radhepa/sic-inverter-800v/figures/03b_loop_inductance.png

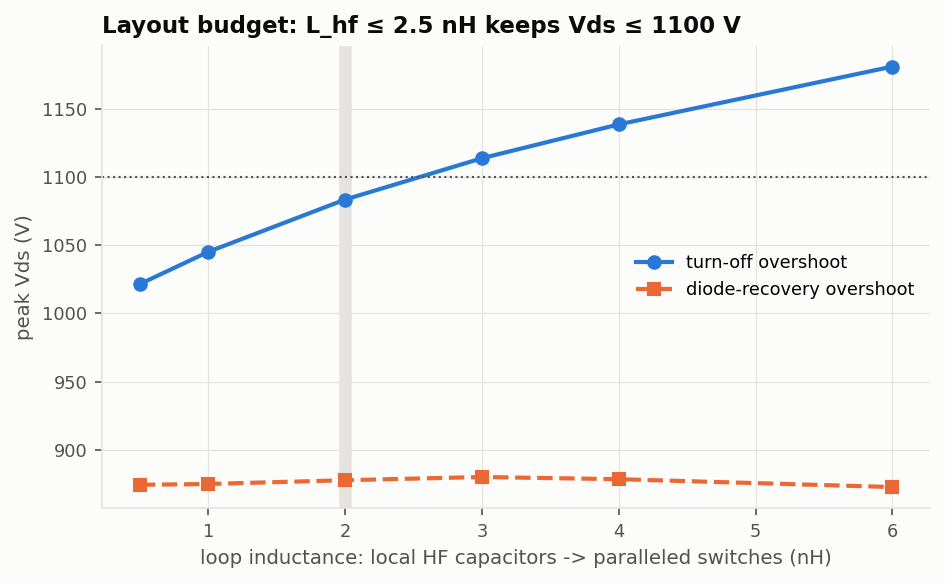
figures/03b_loop_inductance.png
