radhepa/sic-inverter-800v/figures/03c_energy_table.png

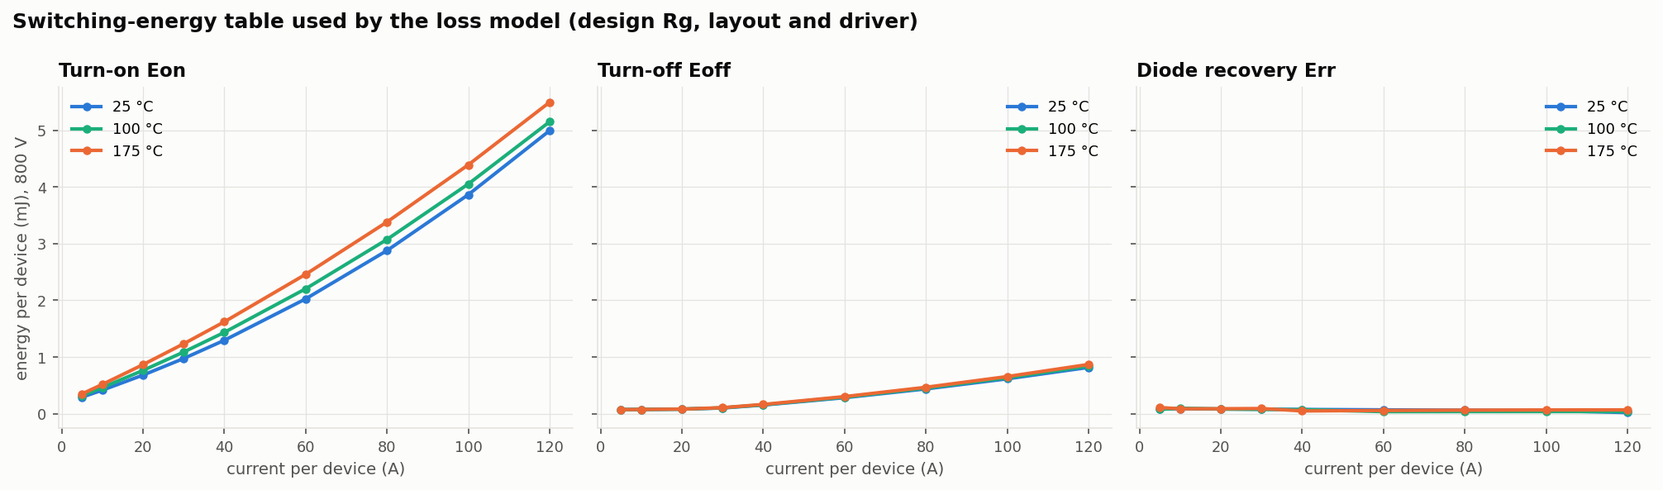
figures/03c_energy_table.png
