radhepa/sic-inverter-800v/figures/03e_paralleling.png

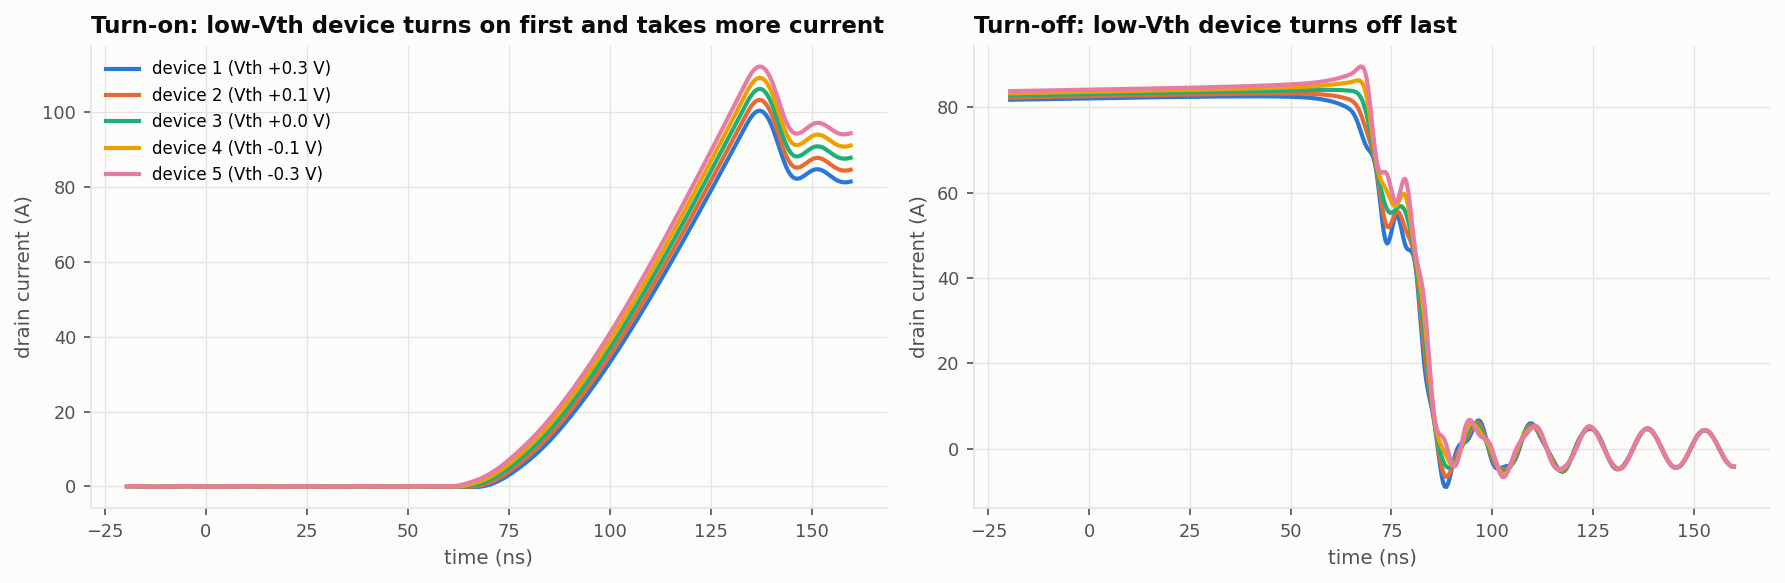
figures/03e_paralleling.png
