radhepa/sic-inverter-800v/figures/03f_short_circuit.png

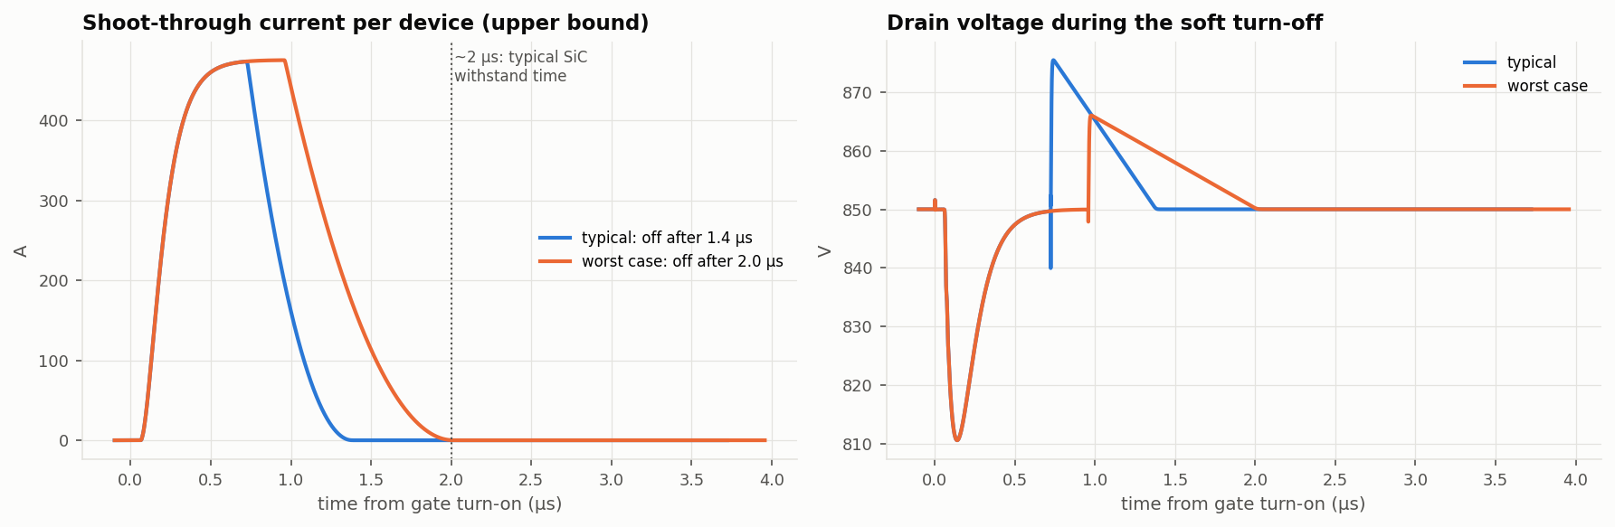
figures/03f_short_circuit.png
