radhepa/sic-inverter-800v/figures/04a_thermal_sizing.png

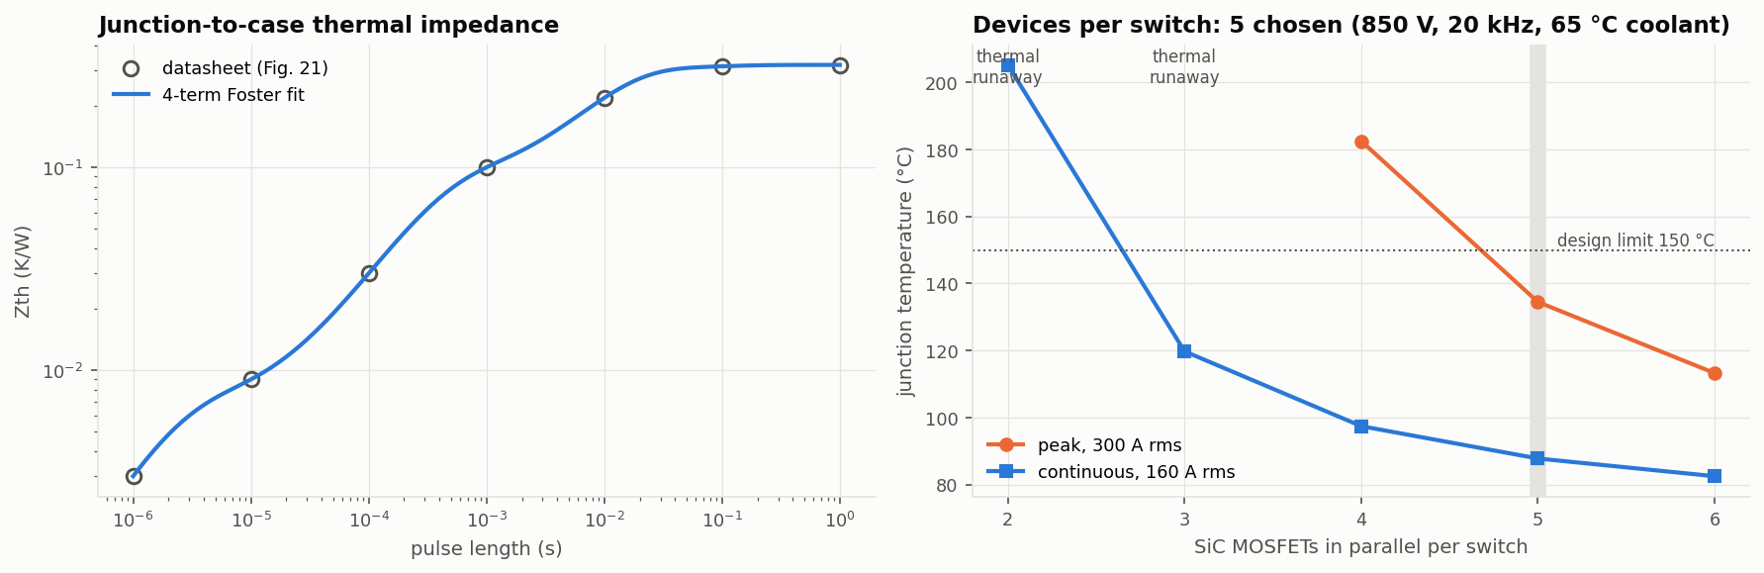
figures/04a_thermal_sizing.png
