radhepa/sic-inverter-800v/figures/04b_efficiency.png

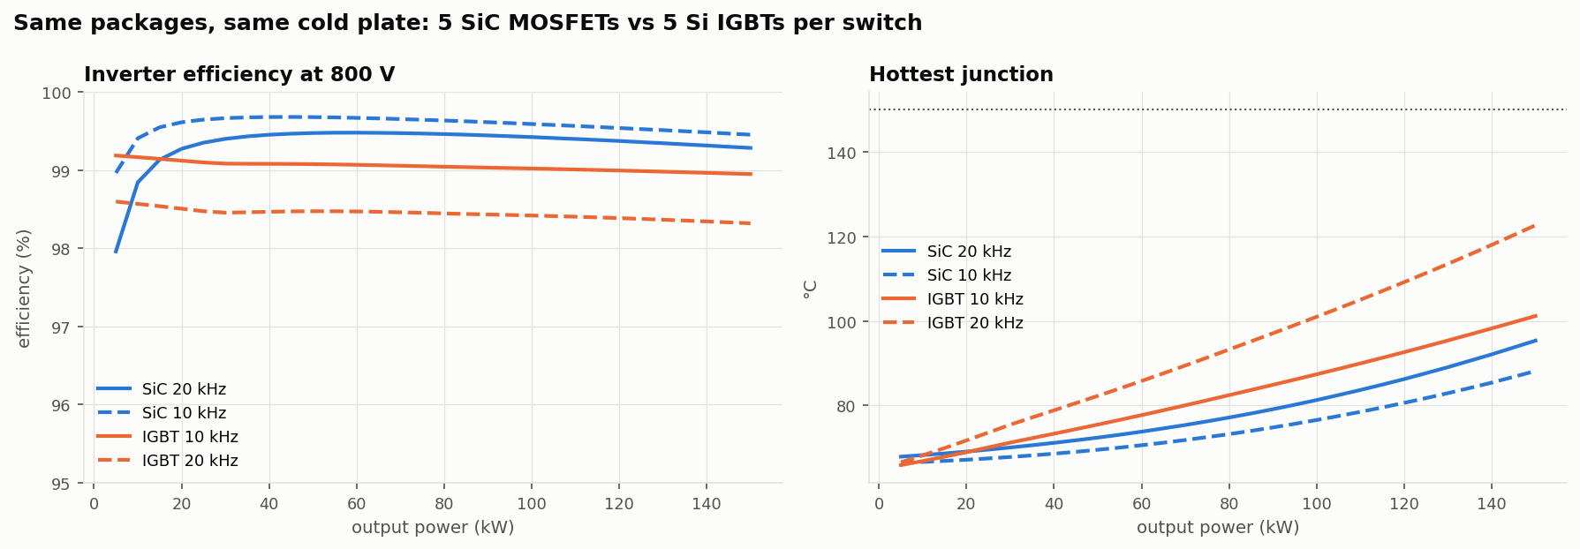
figures/04b_efficiency.png
