radhepa/sic-inverter-800v/figures/05a_udds_trace.png

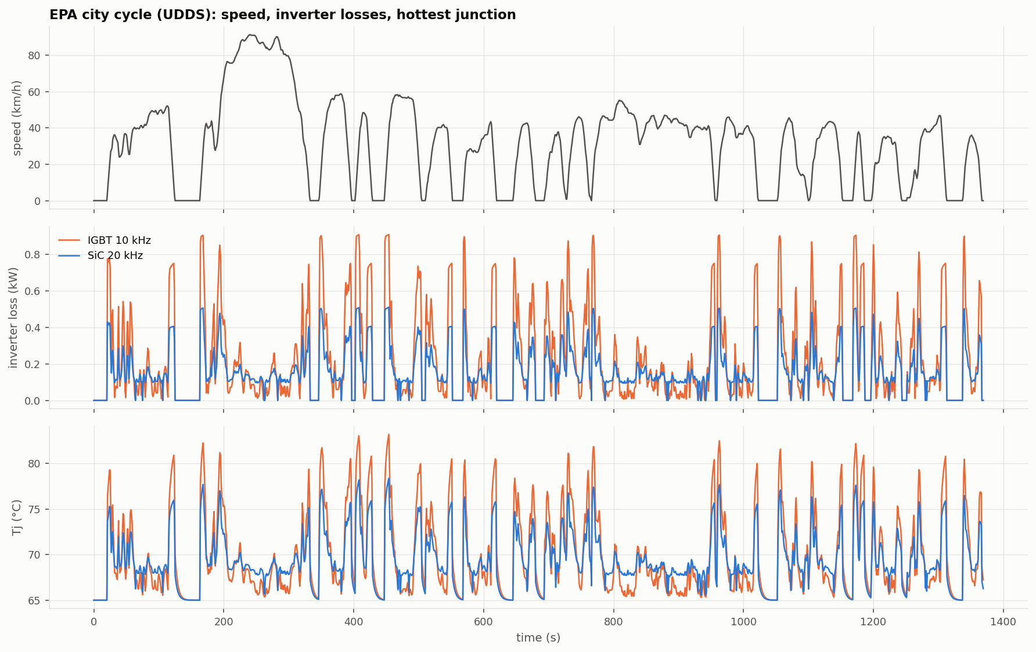
figures/05a_udds_trace.png
