radhepa/sic-inverter-800v/data/dpt_validation.csv

figure | x_name | x | eon_model_mJ | eon_datasheet_mJ | eoff_model_mJ | eoff_datasheet_mJ | calibration_point
Fig. 24 | Id_A | 10 | 0.32765462416995195 | 0.32 | 0.0747562800062425 | 0.07 | False
Fig. 24 | Id_A | 20 | 0.48366963049585765 | 0.47 | 0.08416966516481357 | 0.08 | False
Fig. 24 | Id_A | 30 | 0.6488144276136523 | 0.62 | 0.13337545949900956 | 0.12 | False
Fig. 24 | Id_A | 40 | 0.8245621961109789 | 0.8 | 0.2016775272820796 | 0.18 | False
Fig. 24 | Id_A | 50 | 1.0100364896522354 | 1.0 | 0.2820926298275231 | 0.27 | True
Fig. 24 | Id_A | 60 | 1.2070423895989717 | 1.22 | 0.37111766945972213 | 0.37 | False
Fig. 24 | Id_A | 70 | 1.4147498424134817 | 1.46 | 0.47072808914903447 | 0.48 | False
Fig. 24 | Id_A | 80 | 1.635191634259261 | 1.73 | 0.578731044030402 | 0.6 | False
Fig. 25 | Rg_ohm | 2.5 | 1.0100364896522354 | 1.1 | 0.2820926298275231 | 0.3 | True
Fig. 25 | Rg_ohm | 5 | 1.157091938804863 | 1.3 | 0.35186476236245584 | 0.46 | False
Fig. 25 | Rg_ohm | 10 | 1.4497303386892648 | 1.7 | 0.5165866387291215 | 0.77 | False
Fig. 25 | Rg_ohm | 15 | 1.7492307396171416 | 2.1 | 0.7018701784020651 | 1.09 | False
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
