radhepa/sic-inverter-800v/hardware/gate-driver/gate_driver.kicad_sch

## KiCad design hardware/gate-driver/gate_driver.kicad_sch (2026-10-08)

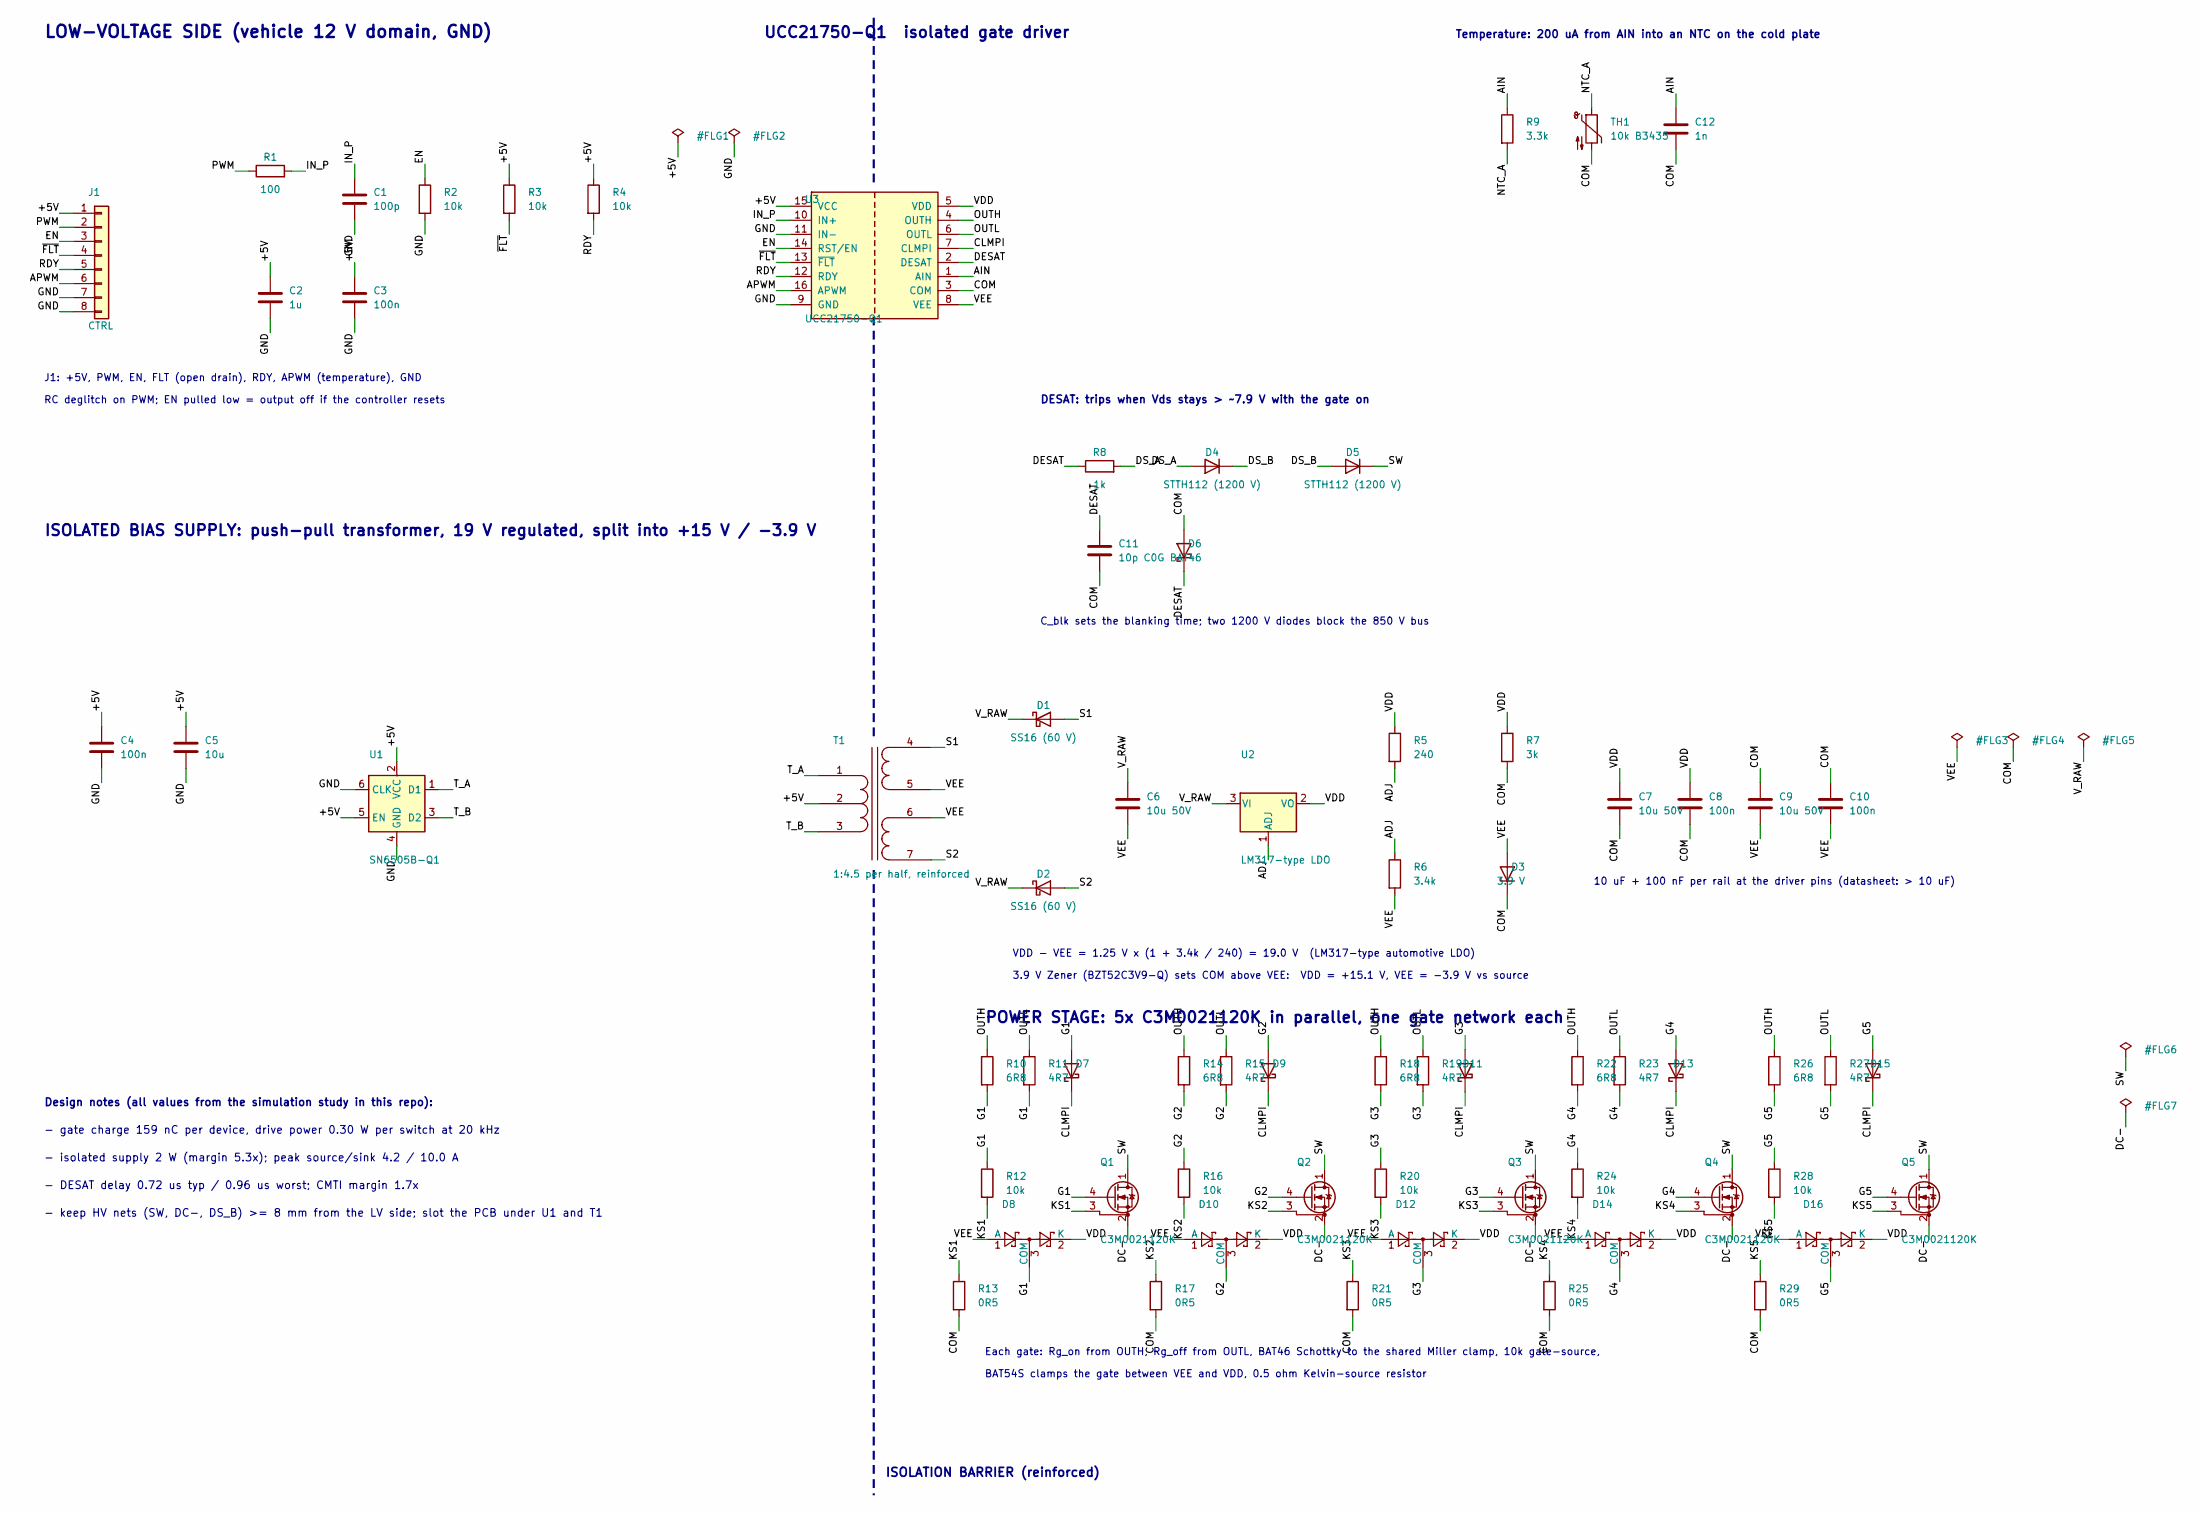
[picture p17: schematic gate_driver.kicad_sch]

Parts:
C1: 100p; C_0805_2012Metric
C2: 1u; C_0805_2012Metric
C3, C4, C8, C10: 100n; C_0805_2012Metric
C5: 10u; C_1210_3225Metric
C6, C7, C9: 10u 50V; C_1210_3225Metric
C11: 10p C0G; C_0805_2012Metric
C12: 1n; C_0805_2012Metric
D1, D2: SS16 (60 V); D_SMA
D3: 3.9 V; D_SOD-123
D4, D5: STTH112 (1200 V); D_SMA
D6, D7, D9, D11, D13, D15: BAT46; D_SOD-123
D8, D10, D12, D14, D16: BAT54S; SOT-23
J1: CTRL; PinHeader_1x08_P2.54mm_Vertical
Q1, Q2, Q3, Q4, Q5: C3M0021120K; TO-247-4_Vertical
R1: 100; R_0805_2012Metric
R2, R3, R4, R12, R16, R20, R24, R28: 10k; R_0805_2012Metric
R5: 240; R_0805_2012Metric
R6: 3.4k; R_0805_2012Metric
R7: 3k; R_0805_2012Metric
R8: 1k; R_0805_2012Metric
R9: 3.3k; R_0805_2012Metric
R10, R14, R18, R22, R26: 6R8; R_1206_3216Metric
R11, R15, R19, R23, R27: 4R7; R_1206_3216Metric
R13, R17, R21, R25, R29: 0R5; R_0805_2012Metric
T1: 1:4.5 per half, reinforced
TH1: 10k B3435; R_0805_2012Metric
U1: SN6505B-Q1; SOT-23-6
U2: LM317-type LDO; SOT-223-3_TabPin2
U3: UCC21750-Q1; SOIC-16W_7.5x10.3mm_P1.27mm

Connections:
+5V: C2.1, C3.1, C4.1, C5.1, J1.1, R3.1, R4.1, T1.2 (PM), U1.2 (VCC), U1.5 (EN), U3.15 (VCC)
ADJ: R5.2, R6.1, U2.1 (ADJ)
AIN: C12.1, R9.1, U3.1 (AIN)
APWM: J1.6, U3.16 (APWM)
CLMPI: D7.1 (K), D9.1 (K), D11.1 (K), D13.1 (K), D15.1 (K), U3.7 (CLMPI)
COM: C7.2, C8.2, C9.1, C10.1, C11.2, C12.2, D3.1 (K), D6.2 (A), R7.2, R13.2, R17.2, R21.2, R25.2, R29.2, TH1.2, U3.3 (COM)
DC-: Q1.2 (S), Q2.2 (S), Q3.2 (S), Q4.2 (S), Q5.2 (S)
DESAT: C11.1, D6.1 (K), R8.1, U3.2 (DESAT)
DS_A: D4.2 (A), R8.2
DS_B: D4.1 (K), D5.2 (A)
EN: J1.3, R2.1, U3.14 (RST/EN)
G1: D7.2 (A), D8.3 (COM), Q1.4 (G), R10.2, R11.2, R12.1
G2: D9.2 (A), D10.3 (COM), Q2.4 (G), R14.2, R15.2, R16.1
G3: D11.2 (A), D12.3 (COM), Q3.4 (G), R18.2, R19.2, R20.1
G4: D13.2 (A), D14.3 (COM), Q4.4 (G), R22.2, R23.2, R24.1
G5: D15.2 (A), D16.3 (COM), Q5.4 (G), R26.2, R27.2, R28.1
GND: C1.2, C2.2, C3.2, C4.2, C5.2, J1.7, J1.8, R2.2, U1.4 (GND), U1.6 (CLK), U3.9 (GND), U3.11 (IN-)
IN_P: C1.1, R1.2, U3.10 (IN+)
KS1: Q1.3 (DS), R12.2, R13.1
KS2: Q2.3 (DS), R16.2, R17.1
KS3: Q3.3 (DS), R20.2, R21.1
KS4: Q4.3 (DS), R24.2, R25.1
KS5: Q5.3 (DS), R28.2, R29.1
NTC_A: R9.2, TH1.1
OUTH: R10.1, R14.1, R18.1, R22.1, R26.1, U3.4 (OUTH)
OUTL: R11.1, R15.1, R19.1, R23.1, R27.1, U3.6 (OUTL)
PWM: J1.2, R1.1
RDY: J1.5, R4.2, U3.12 (RDY)
S1: D1.2 (A), T1.4 (OUT1A)
S2: D2.2 (A), T1.7 (OUT2B)
SW: D5.1 (K), Q1.1 (D), Q2.1 (D), Q3.1 (D), Q4.1 (D), Q5.1 (D)
T_A: T1.1 (IN+), U1.1 (D1)
T_B: T1.3 (IN-), U1.3 (D2)
VDD: C7.1, C8.1, D8.2 (K), D10.2 (K), D12.2 (K), D14.2 (K), D16.2 (K), R5.1, R7.1, U2.2 (VO), U3.5 (VDD)
VEE: C6.2, C9.2, C10.2, D3.2 (A), D8.1 (A), D10.1 (A), D12.1 (A), D14.1 (A), D16.1 (A), R6.2, T1.5 (OUT1B), T1.6 (OUT2A), U3.8 (VEE)
V_RAW: C6.1, D1.1 (K), D2.1 (K), U2.3 (VI)
~FLT: J1.4, R3.2, U3.13 (~FLT)

Notes on the sheet:
LOW-VOLTAGE SIDE (vehicle 12 V domain, GND)
J1: +5V, PWM, EN, FLT (open drain), RDY, APWM (temperature), GND
RC deglitch on PWM; EN pulled low = output off if the controller resets
ISOLATED BIAS SUPPLY: push-pull transformer, 19 V regulated, split into +15 V / -3.9 V
VDD - VEE = 1.25 V x (1 + 3.4k / 240) = 19.0 V (LM317-type automotive LDO)
3.9 V Zener (BZT52C3V9-Q) sets COM above VEE: VDD = +15.1 V, VEE = -3.9 V vs source
10 uF + 100 nF per rail at the driver pins (datasheet: > 10 uF)
UCC21750-Q1 isolated gate driver
DESAT: trips when Vds stays > ~7.9 V with the gate on
C_blk sets the blanking time; two 1200 V diodes block the 850 V bus
Temperature: 200 uA from AIN into an NTC on the cold plate
POWER STAGE: 5x C3M0021120K in parallel, one gate network each
Each gate: Rg_on from OUTH, Rg_off from OUTL, BAT46 Schottky to the shared Miller clamp, 10k gate-source,
BAT54S clamps the gate between VEE and VDD, 0.5 ohm Kelvin-source resistor
ISOLATION BARRIER (reinforced)
Design notes (all values from the simulation study in this repo):
- gate charge 159 nC per device, drive power 0.30 W per switch at 20 kHz
- isolated supply 2 W (margin 5.3x); peak source/sink 4.2 / 10.0 A
- DESAT delay 0.72 us typ / 0.96 us worst; CMTI margin 1.7x
- keep HV nets (SW, DC-, DS_B) >= 8 mm from the LV side; slot the PCB under U1 and T1
