radhepa/sic-inverter-800v/(commit log)

2026-10-08 800 V SiC traction inverter switch: design study
    SPICE model of the C3M0021120K fitted to its datasheet, double-pulse
    bench calibrated at one point and validated on 14 others, design
    studies for gate resistors, layout inductance, crosstalk, paralleling
    and DESAT short-circuit protection, electro-thermal loss model vs a
    silicon IGBT over EPA drive cycles, worst-case analysis with Monte
    Carlo, and a KiCad schematic of the UCC21750-Q1 gate driver with five
    paralleled devices.
2026-10-08 Count the 50 A datasheet point as calibration, not validation
    The 50 A / 2.5 ohm / 25 C entry of the current sweep repeats the
    calibration conditions, so it is excluded from the validation set
    (13 independent points; current-sweep mean error 3.6 %).
